penhirai/UsbPowerSupply/order/Pcbgogo/20180331/readme.txt

readme.txt ... 

UsbPowerSupply.cmp ... pattern component side (L1)
UsbPowerSupply.sol ... pattern solder side (L2)
UsbPowerSupply.stc ... Solder stop component side
UsbPowerSupply.sts ... Solder stop solder side
UsbPowerSupply.plc ... Silkscreen component side
UsbPowerSupply.pls ... Silkscreen solder side
UsbPowerSupply.crc ... Cream component side
UsbPowerSupply.crs ... Cream solder side
UsbPowerSupply.out ... outline file
UsbPowerSupply.dri ... Drill table
UsbPowerSupply.drd ... Drill data

PositionUsbPowerSupply.pos ... Mount position component/solder side
BomUsbPowerSupply.xlsx ... Bom list

UsbPowerSupply_GBView_Cmp.pdf        ... Gerber View Component side with Description
UsbPowerSupply_GBView_Sol_Mirror.pdf ... Gerber View Solder side with Description
