penhirai/UsbPowerSupply/order/Pcbgogo/20180331/BomUsbPowerSupply.xlsx

品名 Name | 部品番号 Designator | 個数 Quantity | 値 Value | パッケージ Package | 説明 Description | 部品メーカー Manufacturer | 部品メーカーの品番 Manufacturer Part Number | 実装 / 非実装 | 代替可否
抵抗 | R8, R10, R11, R12 | 4 | 0 | 1005 | RESISTOR, European symbol | KOA | RK73Z1ETTP | 実装 | 可
抵抗 | R2, R17, R18 | 3 | 0 | 1005 | RESISTOR, European symbol | KOA | RK73Z1ETTP | 非実装 | 可
抵抗 | R3, R4, R6 | 3 | 1.3k | 1005 | RESISTOR, European symbol | KOA | RK73H1ETTP1301F | 実装 | 可
抵抗 | R16 | 1 | 100k | 1005 | RESISTOR, European symbol | KOA | RK73H1ETTP1003F | 実装 | 可
抵抗 | R1, R5, R9 | 3 | 10k | 1005 | RESISTOR, European symbol | KOA | RK73H1ETTP1002F | 実装 | 可
コンデンサ | C4, C5 | 2 | 16V 0.1uF | 1005 | CAPACITOR, European symbol | Murata | GRM155R71E104KE14J | 実装 | 不可
コンデンサ | C1, C2, C3, C6, C8 | 5 | 16V 10uF | 1608 | CAPACITOR, European symbol | Taiyo Yuden | EMK107BBJ106MA-T | 実装 | 可
コンデンサ | C7 | 1 | 16V 68uF | 7343 |  | Panasonic | EEF-CX1C680R | 実装 | 不可
抵抗 | R13 | 1 | 220k | 1005 | RESISTOR, European symbol | KOA | RK73H1ETTP2203F | 実装 | 可
抵抗 | R7 | 1 | 33k | 1005 | RESISTOR, European symbol | KOA | RK73H1ETTP3302F | 実装 | 可
抵抗 | R15 | 1 | 5.1k | 1005 | RESISTOR, European symbol | KOA | RK73H1ETTP5101F | 実装 | 可
可変抵抗 | VR1 | 1 | 500k | スルーホール |  | Bourns | 3006P-1-504LF | 実装 | 可
抵抗 | R14 | 1 | 75k | 1005 | RESISTOR, European symbol | KOA | RK73H1ETTP7502F | 実装 | 可
USB コネクタ（A レセプタクル） | J2 | 1 | ー | SMD |  | CNC Tech | 1001-002-01100 | 実装 | 可
LED | LED1 | 1 | ー | 1005 |  | Kingbright | APHHS1005SURCK | 実装 | 不可
基準穴 | S1, S2 | 2 | ー | ー | BASE_HOLE | ー | ー | ー
インダクタ | L1 | 1 | ー | 1608 | INDUCTOR, European symbol | Murata | BLM18KG601SN1D | 実装 | 不可
ガイド穴 | S3 | 1 | ー | ー | GUIDE_HOLE_1 | ー | ー | ー
ガイド穴 | S4 | 1 | ー | ー | GUIDE_HOLE_2 | ー | ー | ー
インダクタ | L2 | 1 | ー | 4020 | SMD Metal Alloy Power Inductor | Taiyo Yuden | MDWK4040T1R5MM | 実装 | 不可
USB コネクタ（microB レセプタクル） | J1 | 1 | ー | SMD | Connector Receptacle USB - micro B 2.0 5 Position Surface Mount, Right Angle, Horizontal | Hirose | ZX62-B-5PA(33) | 実装 | 不可
電源スイッチ IC | U1 | 1 | ー | UDFN6 |  | On Semiconductor | NCP380HMUAJAATBG | 実装 | 不可
認識マーク | S5 | 1 | ー | ー | RECOG_MARK_1 | ー | ー | ー
認識マーク | S6 | 1 | ー | ー | RECOG_MARK_2 | ー | ー | ー
認識マーク | S7 | 1 | ー | ー | RECOG_MARK_3 | ー | ー | ー
スイッチ | SW1 | 1 | ー | SMD |  | Alps | SSAJ120100 | 実装 | 不可
スルーホール | J4, J5, J6 | 3 | ー | ー | スルーホールφ2 | ー | ー | ー
電源 IC | U2 | 1 | ー | 15-VQFN-HR | Wide Input Voltage (2V-16V) Buck-Boost Converter 15-VQFN-HR | Texas Instruments | TPS63070RNMR | 実装 | 不可
