penhirai/UsbPowerSupply/UsbPowerSupplySchematic_20180330.pdf

U2

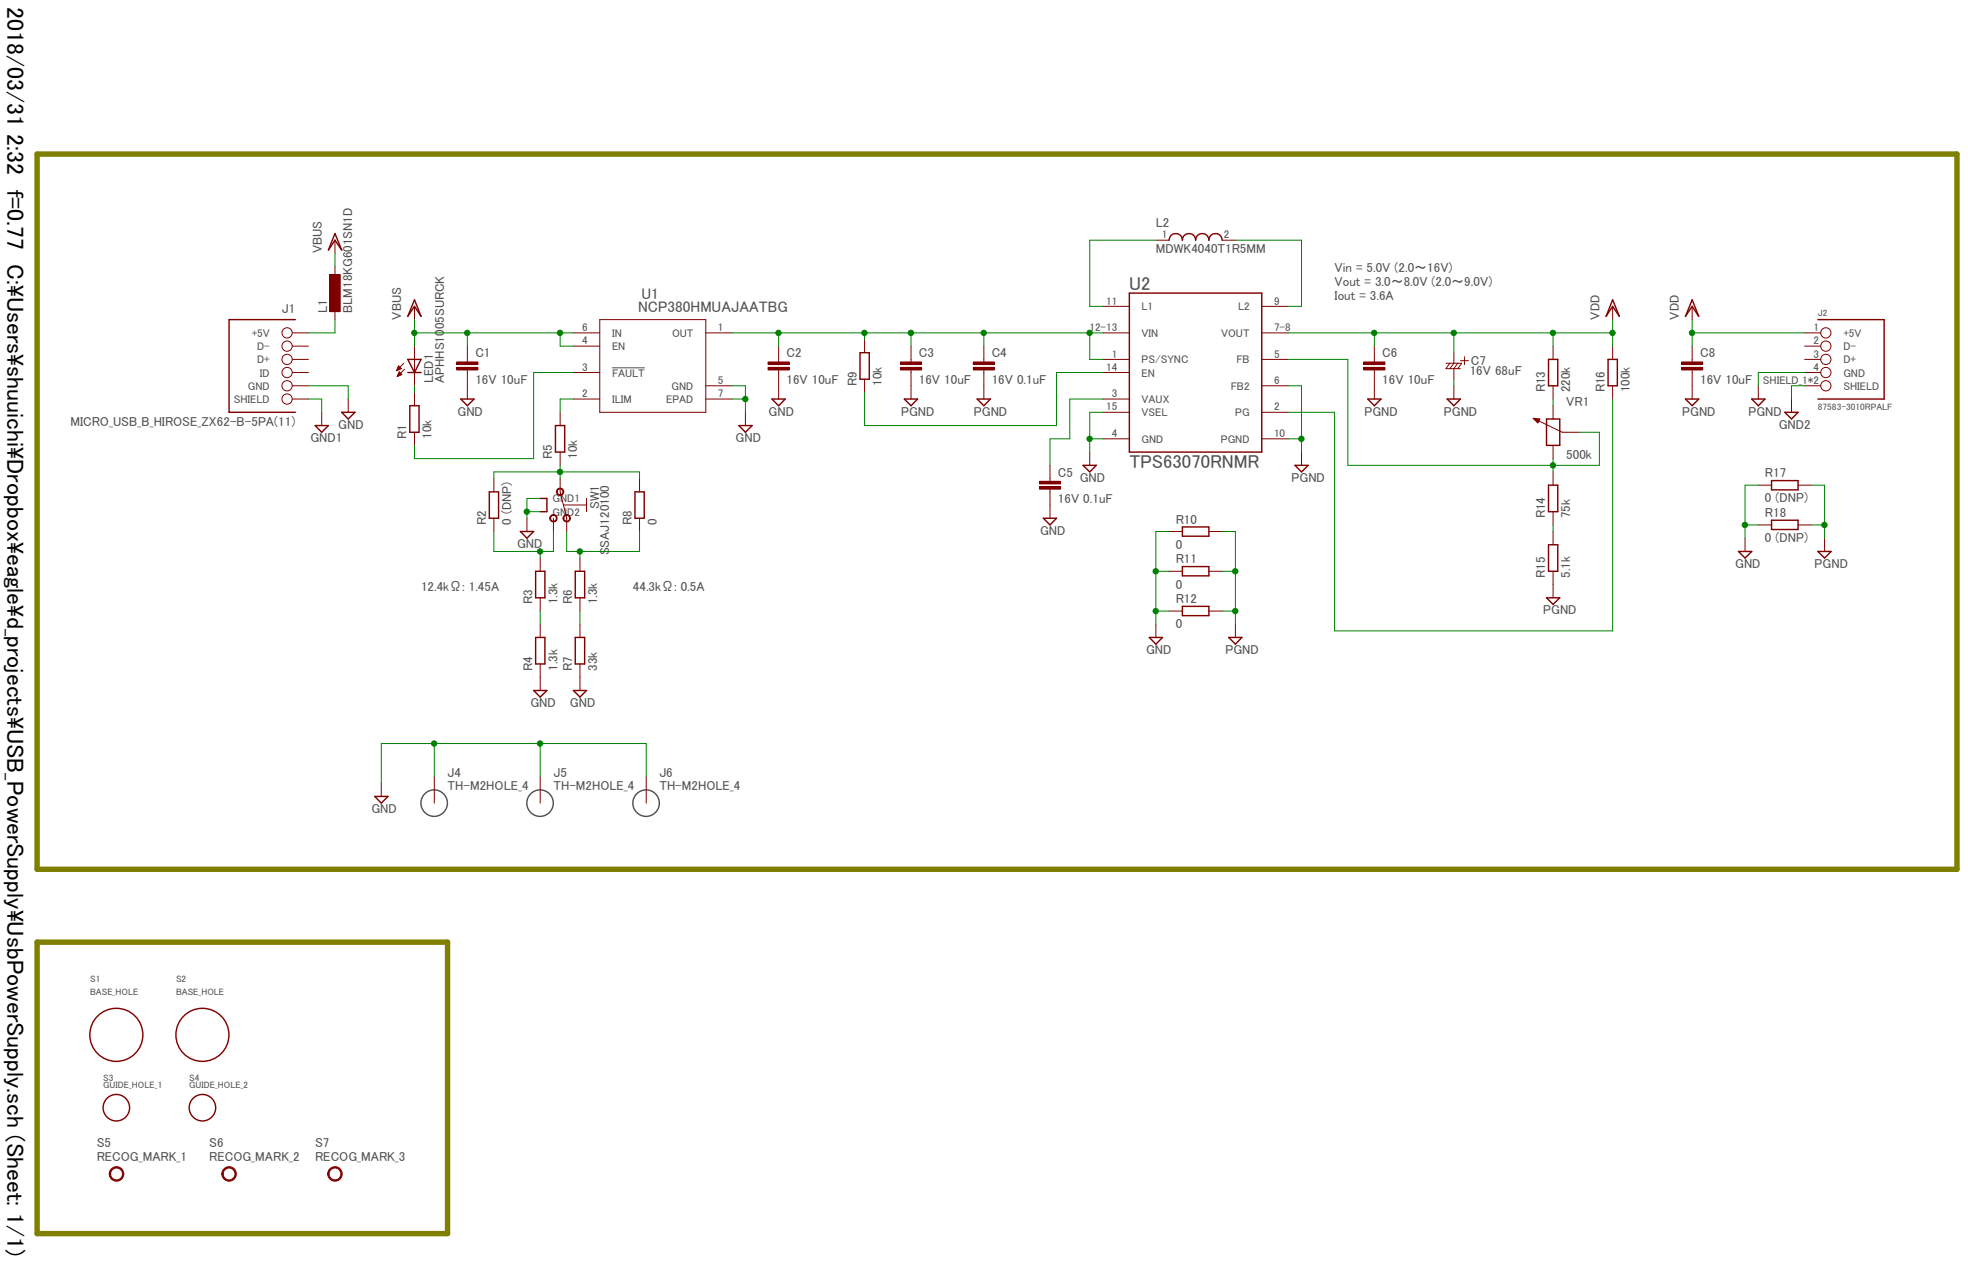
[picture p1: page 1]

2018/03/31 2:32 f=0.77 C:\Users\shuuichi\Dropbox\eagle\d_projects\USB_PowerSupply\UsbPowerSupply.sch (Sheet: 1/1) 12.4kΩ: 1.45A 44.3kΩ: 0.5A Vin = 5.0V (2.0～16V) Vout = 3.0～8.0V (2.0～9.0V) Iout = 3.6A NCP380HMUAJAATBG
