penhirai/UsbPowerSupply/order/Pcbgogo/20180331/UsbPowerSupply_GBView_Cmp.pdf

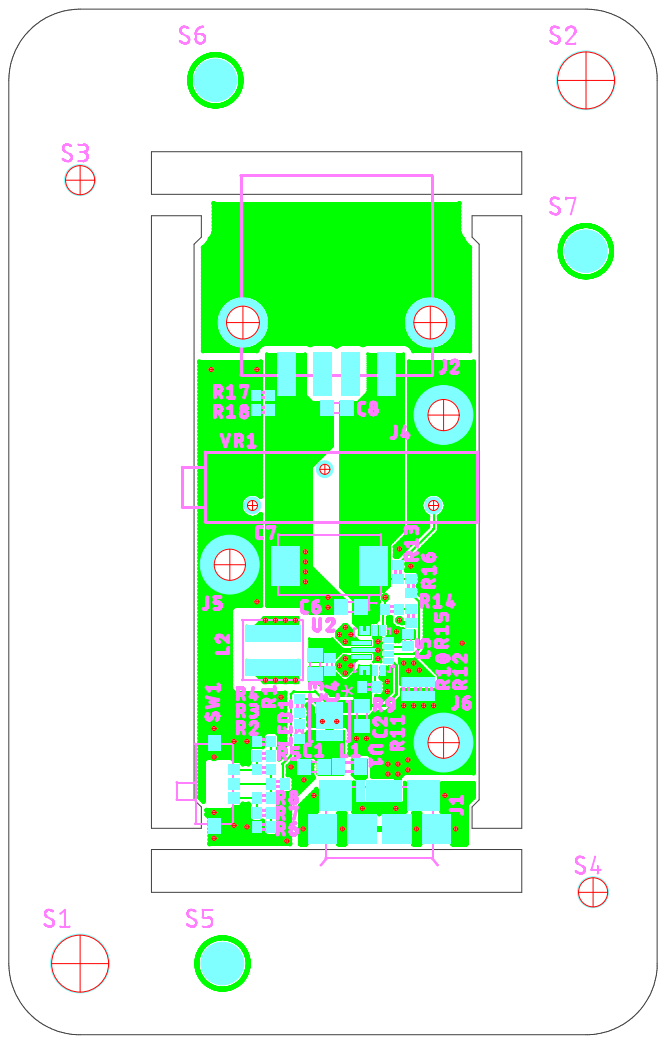
[picture p2: page 1]
