penhirai/UsbPowerSupply/order/Pcbgogo/20180331/UsbPowerSupply_GBView_Sol_Mirror.pdf

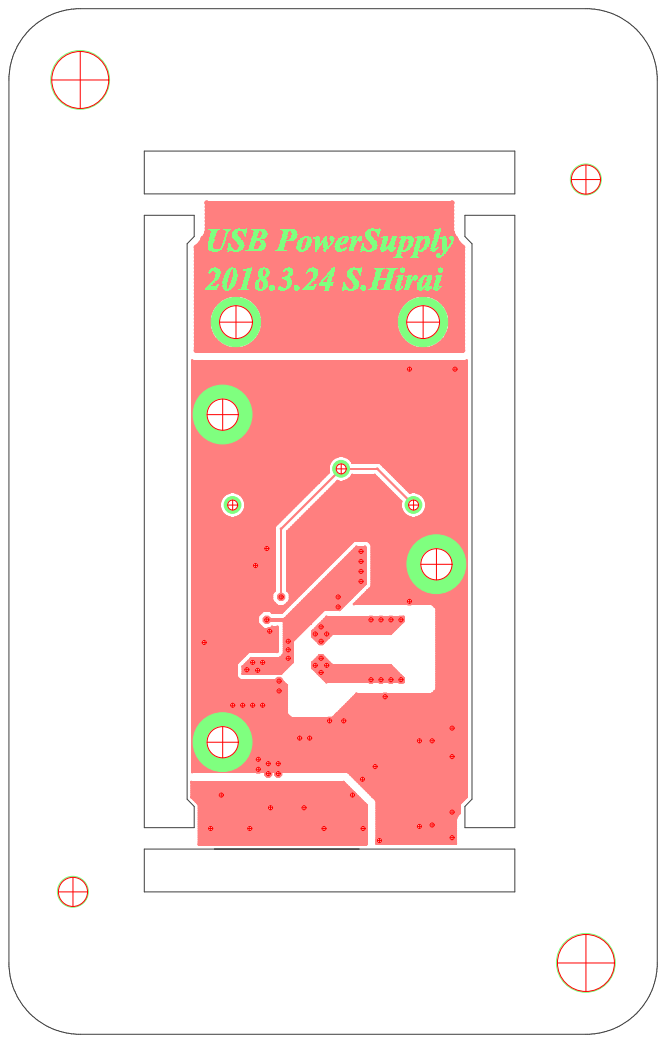
[picture p3: page 1]
