penhirai/UsbPowerSupply/UsbPowerSupply.brd

## EAGLE design UsbPowerSupply.brd (2018-08-14)

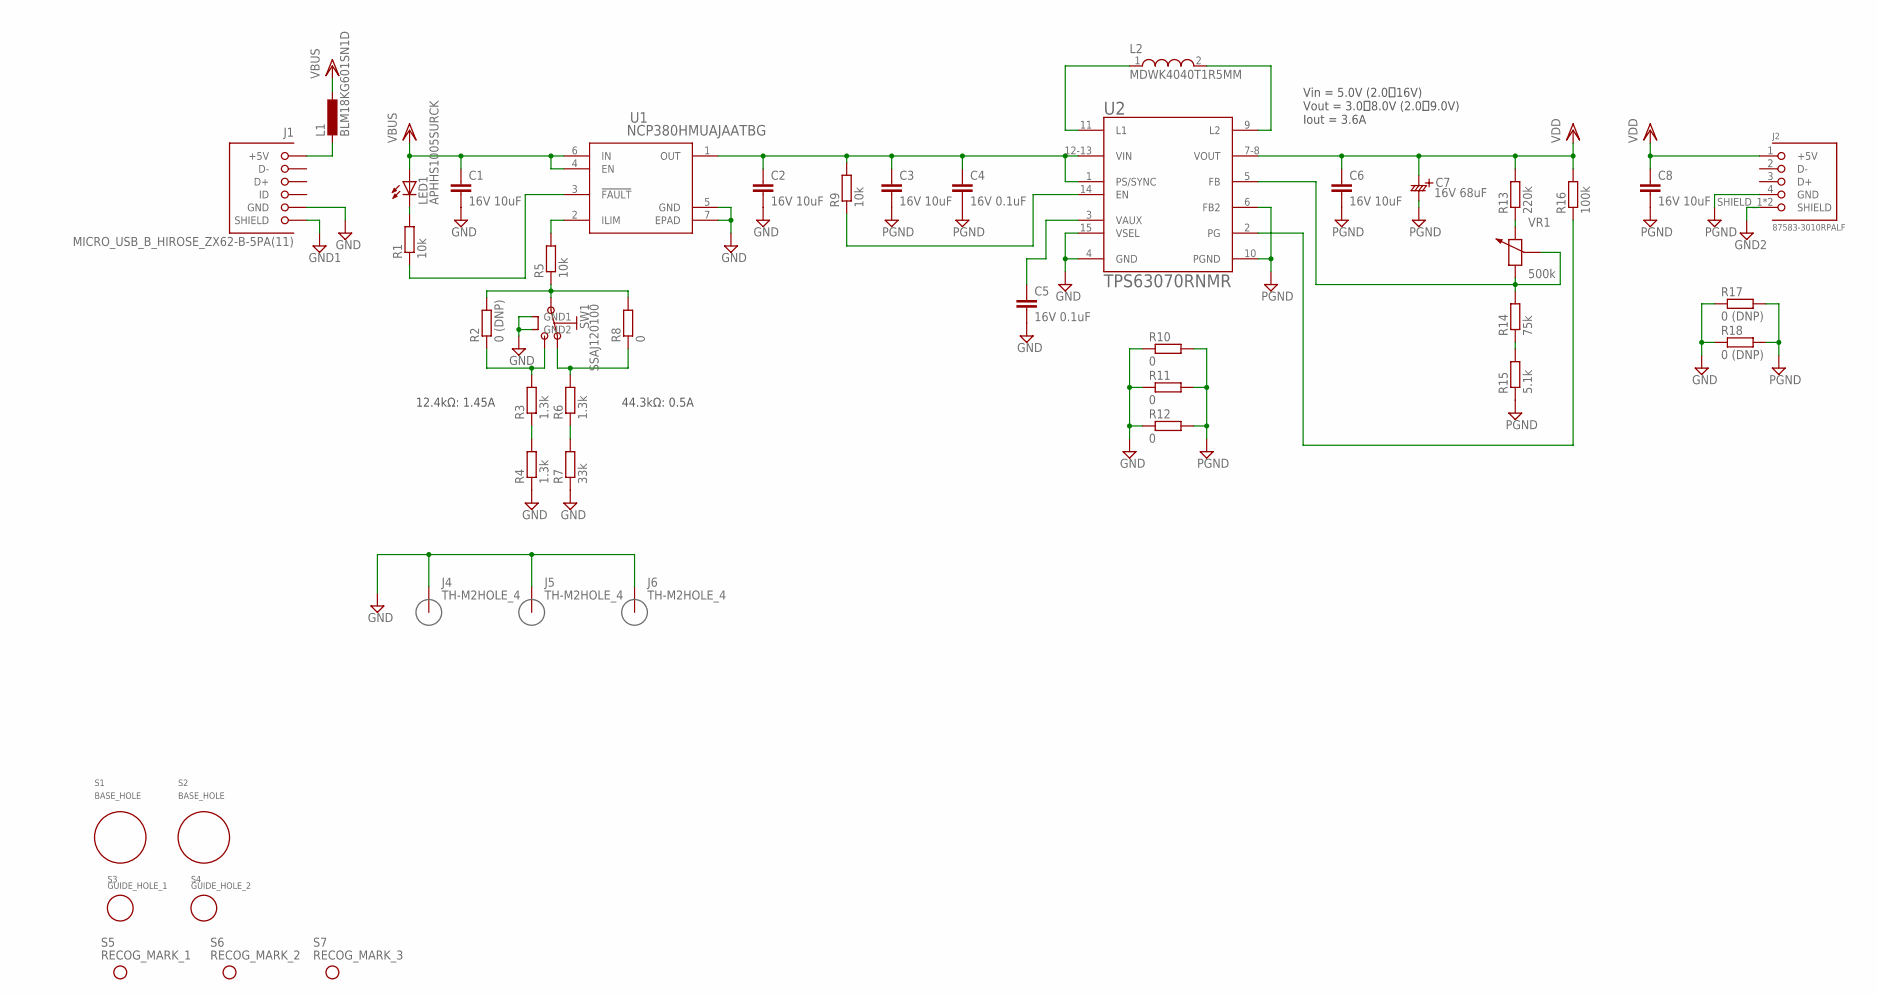
[picture p4: schematic UsbPowerSupply.sch]

Parts:
C1, C2, C3, C6, C8: 16V 10uF; C0603M
C4, C5: 16V 0.1uF; C0402M
C7: 16V 68uF; EEFCX_7343
J1: MICRO_USB_B_HIROSE_ZX62-B-5PA(11); USB_MICRO_B-HIROSE-ZX62-B-5PA(11)
J2: 87583-3010RPALF; USB_A_FEMALE
J4, J5, J6: TH-M2HOLE_4; HOLE_M2_PHI4
L1: BLM18KG601SN1D; L1608
L2: MDWK4040T1R5MM; WE-MAPI_4020
LED1: APHHS1005SURCK; 1005
R1, R5, R9: 10k; R0402R
R2, R17, R18: 0 (DNP); R0402R
R3, R4, R6: 1.3k; R0402R
R7: 33k; R0402R
R8, R10, R11, R12: 0; R0402R
R13: 220k; R0402R
R14: 75k; R0402R
R15: 5.1k; R0402R
R16: 100k; R0402R
S1, S2: BASE_HOLE
S3: GUIDE_HOLE_1; GUIDE_HOLE
S4: GUIDE_HOLE_2; GUIDE_HOLE
S5: RECOG_MARK_1; RECOG_MARK
S6: RECOG_MARK_2; RECOG_MARK
S7: RECOG_MARK_3; RECOG_MARK
SW1: SSAJ120100
U1: NCP380HMUAJAATBG; NCP380_UDFN6
U2: TPS63070RNMR; QFN50P250X300X100-15N
VR1: 500k; VR_3006

Connections:
EN: R9.1, U2.14 (EN)
FB: R14.2, U2.5 (FB), VR1.2 (CENTER), VR1.3 (2)
GND: C1.2, C2.2, C5.2, J1.5 (GND), J4.P$1, J5.P$1, J6.P$1, R4.1, R7.1, R10.1, R11.1, R12.1, R17.1, R18.1, SW1.4 (GND1), SW1.5 (GND2), U1.5 (GND), U1.7 (EPAD), U2.4 (GND), U2.15 (VSEL)
GND1: J1.P$1 (SHIELD), J1.P$2 (SHIELD), J1.P$3 (SHIELD), J1.P$4 (SHIELD), J1.P$5 (SHIELD), J1.P$6 (SHIELD)
GND2: J2.SHIELD_1 (SHIELD), J2.SHIELD_2 (SHIELD)
L1: L2.1, U2.11 (L1)
L2: L2.2, U2.9 (L2)
unnamed: R14.1, R15.2
unnamed: J1.1 (+5V), L1.2
unnamed: LED1.K, R1.2
unnamed: R1.1, U1.3 (!FAULT)
unnamed: R5.2, U1.2 (ILIM)
unnamed: R2.2, R5.1, R8.2, SW1.2
unnamed: R13.1, VR1.1
unnamed: R3.1, R4.2
unnamed: R6.2, R8.1, SW1.3 (1)
unnamed: R2.1, R3.2, SW1.1 (3)
unnamed: R6.1, R7.2
PG: R16.1, U2.2 (PG)
PGND: C3.2, C4.2, C6.2, C7.MINUS, C8.2, J2.4 (GND), R10.2, R11.2, R12.2, R15.1, R17.2, R18.2, U2.6 (FB2), U2.10 (PGND)
VAUX: C5.1, U2.3 (VAUX)
VBUS: C1.1, L1.1, LED1.A, U1.4 (EN), U1.6 (IN)
VBUS2: C2.1, C3.1, C4.1, R9.2, U1.1 (OUT), U2.1 (PS/SYNC), U2.12-13 (VIN)
VDD: C6.1, C7.PLUS, C8.1, J2.1 (+5V), R13.2, R16.2, U2.7-8 (VOUT)

Notes on the sheet:
44.3kΩ: 0.5A
12.4kΩ: 1.45A
Vin = 5.0V (2.0～16V) Vout = 3.0～8.0V (2.0～9.0V) Iout = 3.6A

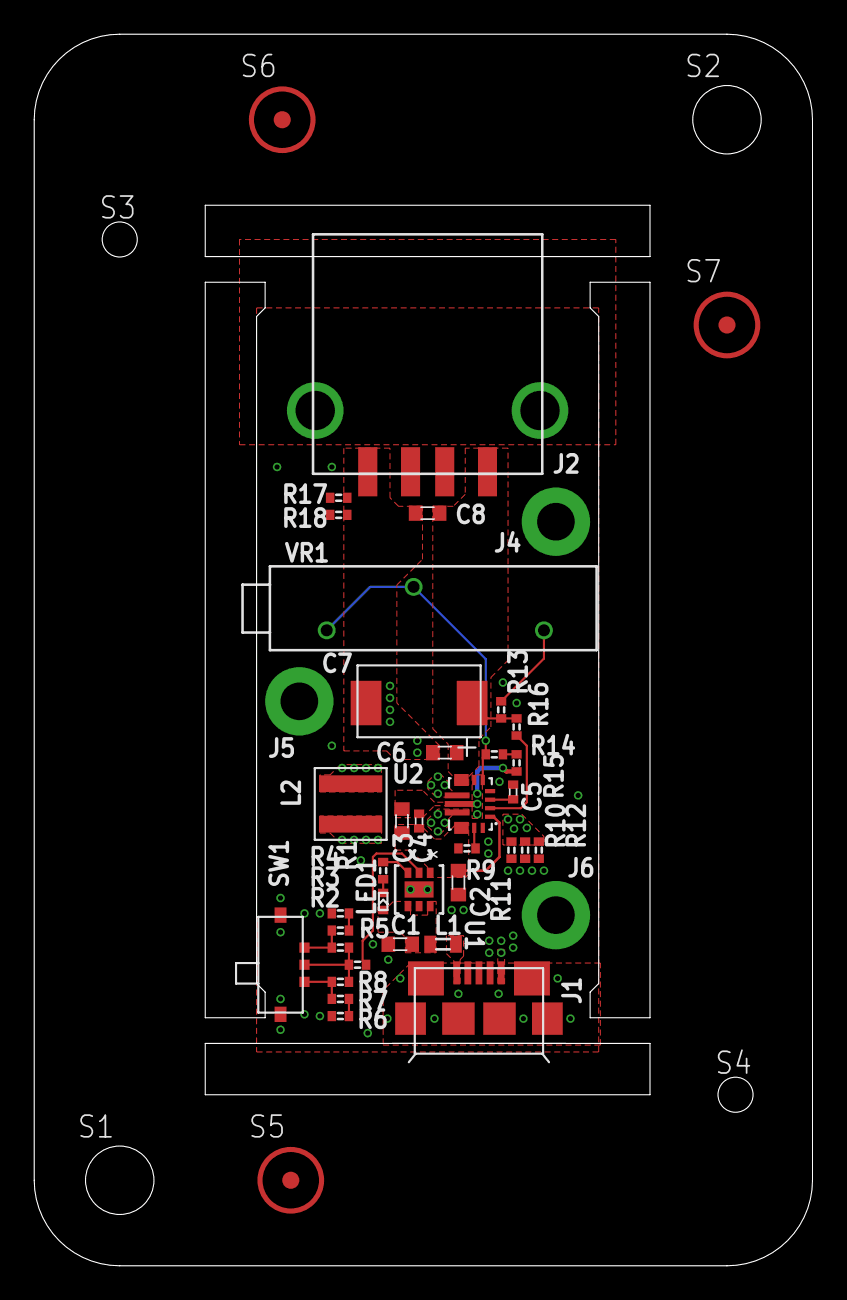
[picture p5: board UsbPowerSupply.brd from above]

Board: 2 copper layers, 45.5 x 72.0 mm, 45 parts (0 on the bottom side), 24 nets.
