penhirai/UsbPowerSupply/(notices)

Notices in the files:
parts and their libraries:
Wurth_Elektronik_Passive_rev15f: Copyright: Würth Elektronik
